Mangta517/flight/flight_remote_hal/MDK-ARM/air_schematic_page1.png

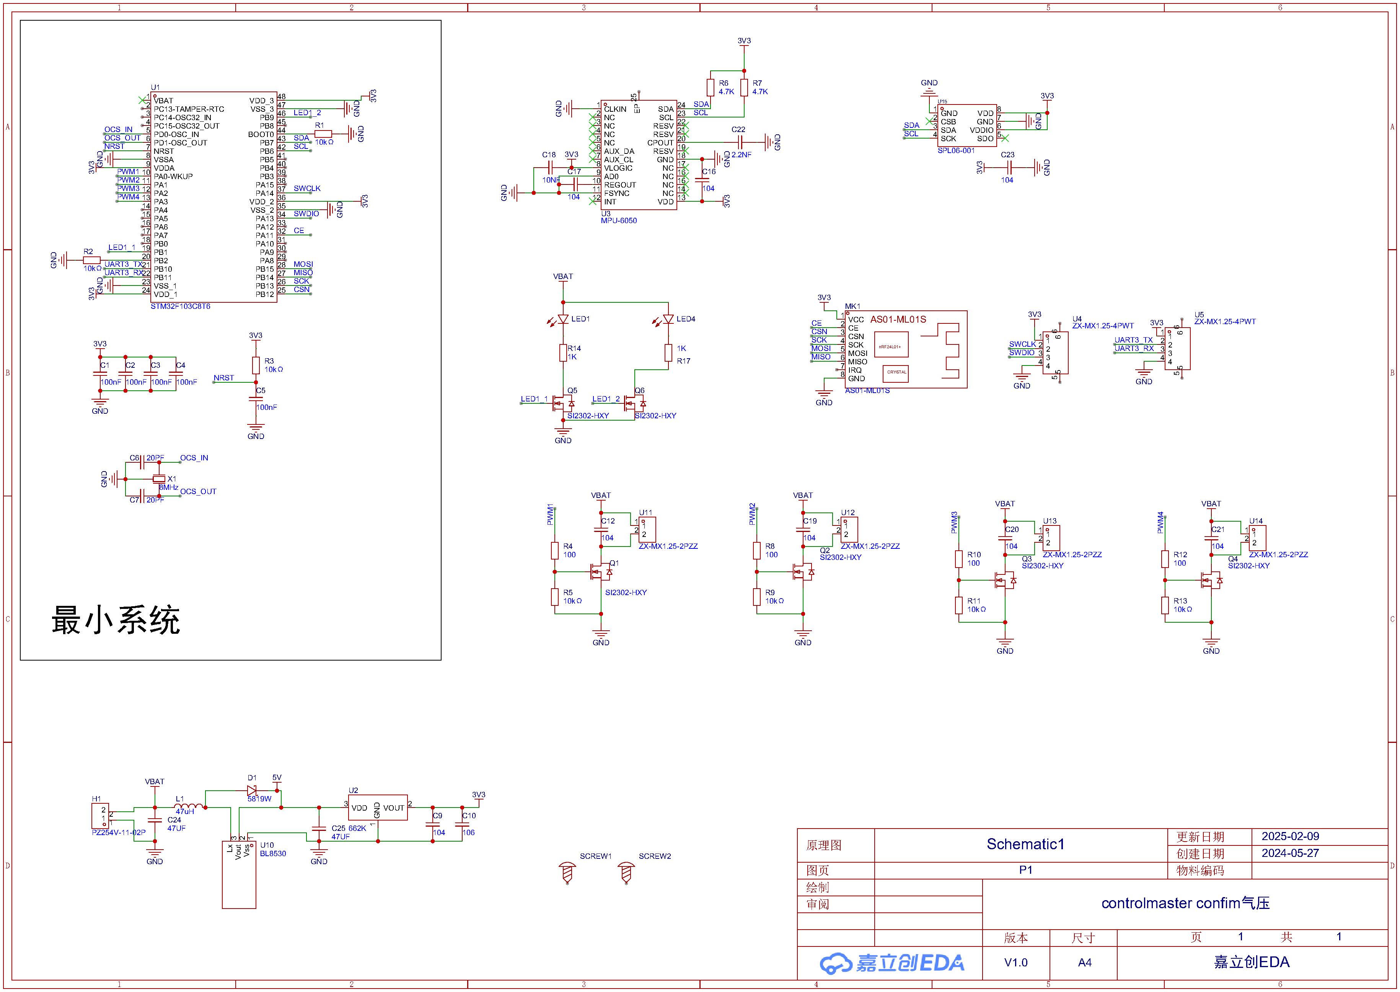
flight_remote_hal/MDK-ARM/air_schematic_page1.png
