Mangta517/flight/flight_remote_hal/MDK-ARM/air_schematic.pdf

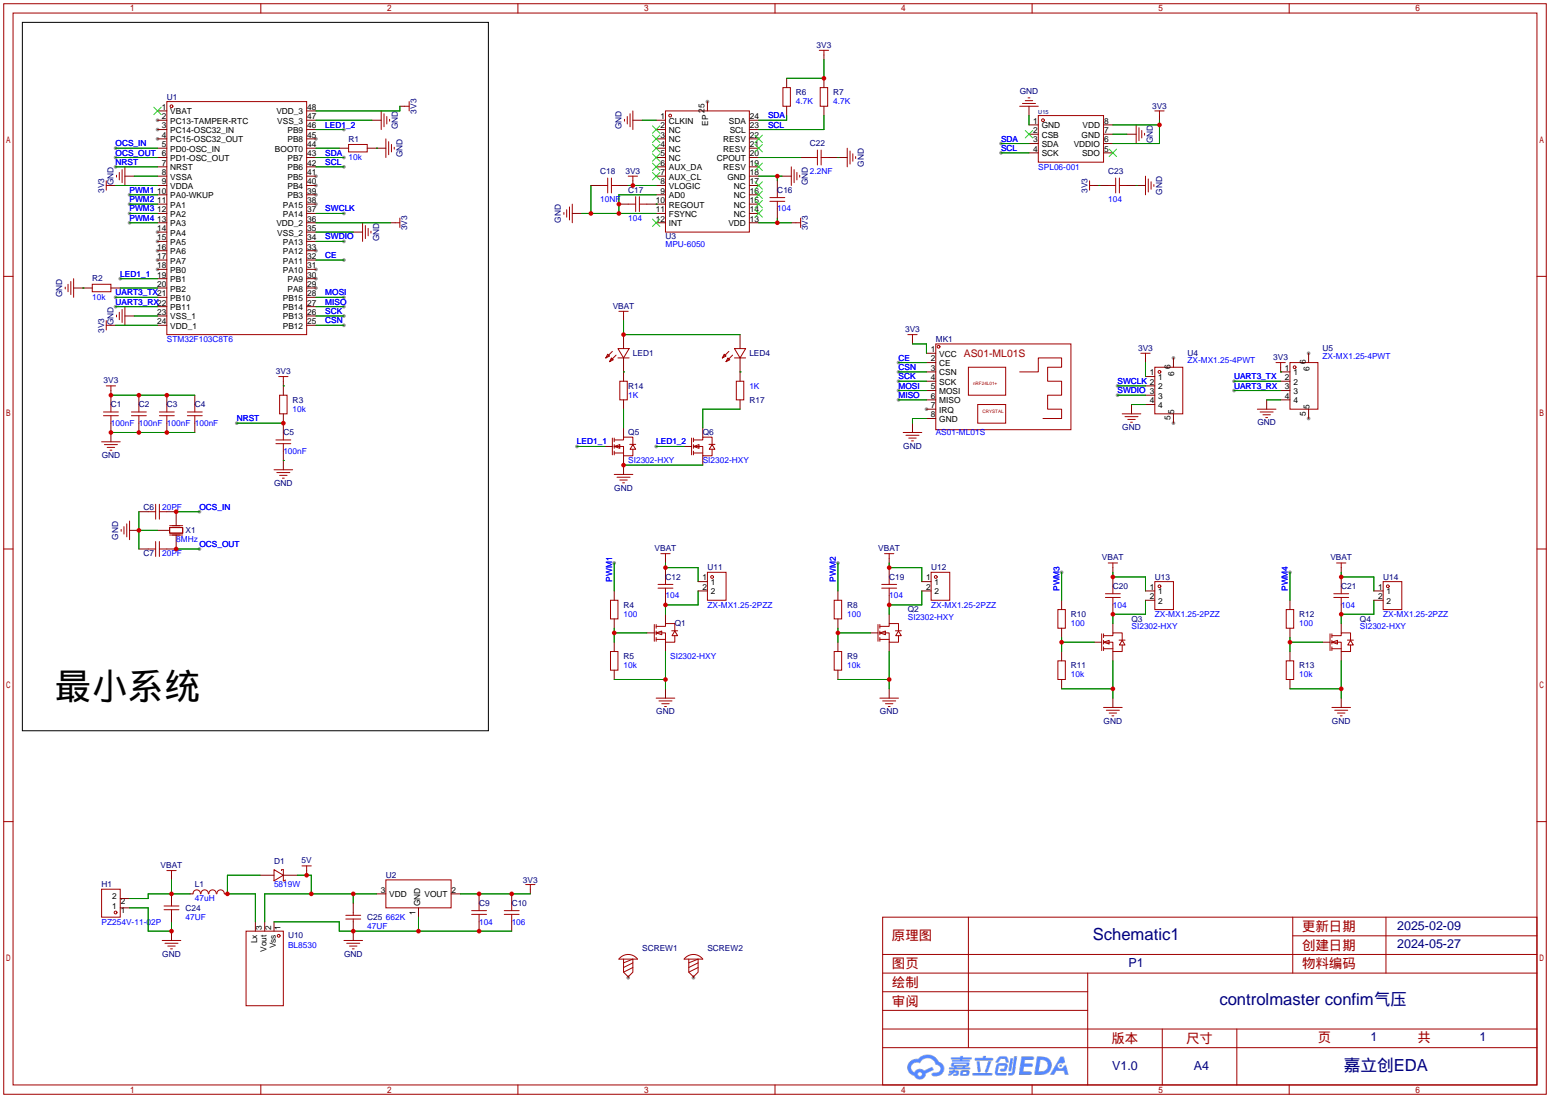
[picture p2: page 1]
