Mangta517/flight/flight_hal/Core/Src/main.c

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
/* Includes ------------------------------------------------------------------*/
#include "main.h"
#include "i2c.h"
#include "spi.h"
#include "tim.h"
#include "usart.h"
#include "gpio.h"

/* USER CODE BEGIN Includes */
#include "common_debug.h"
#include "application_freertos_task.h"
#include "nRF24L01P.h"
#include "spl006.h"
/* USER CODE END Includes */


void SystemClock_Config(void);
/**
  * @brief  The application entry point.
  * @retval int
  */
int main(void)
{

  /* MCU Configuration--------------------------------------------------------*/

  /* Reset of all peripherals, Initializes the Flash interface and the Systick. */
  HAL_Init();

  /* Configure the system clock */
  SystemClock_Config();

  /* Initialize all configured peripherals */
  MX_GPIO_Init();
  MX_USART3_UART_Init();
  MX_TIM2_Init();
  MX_SPI2_Init();
  MX_I2C1_Init();
  /* USER CODE BEGIN 2 */
//HAL_UART_Transmit(&huart3, (uint8_t *)"Hello World\r\n", 13, 1000);
//使用c语言的printf
debug_printf("Hello World\r\n");
Int_nRF24L01P_Init();
spl_Init();
application_freertos_start();


//启动FREERTOS,然后续的任务切换到FREERTOS的任务中去执行

vTaskStartScheduler();
  /* USER CODE END 2 */

  /* Infinite loop */
  /* USER CODE BEGIN WHILE */
  while (1)
  {
    /* USER CODE END WHILE */

    /* USER CODE BEGIN 3 */
  }
  /* USER CODE END 3 */
}

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
