Mangta517/flight/flight_remote_hal/Core/Inc/main.h

#define KEY_UP_Pin GPIO_PIN_14
#define KEY_UP_GPIO_Port GPIOC
#define KEY_DOWN_Pin GPIO_PIN_15
#define KEY_DOWN_GPIO_Port GPIOC
#define KEY_LEFT_Pin GPIO_PIN_6
#define KEY_LEFT_GPIO_Port GPIOA
#define KEY_RIGHT_Pin GPIO_PIN_7
#define KEY_RIGHT_GPIO_Port GPIOA
#define KEY_RIGHT_TOP_Pin GPIO_PIN_11
#define KEY_RIGHT_TOP_GPIO_Port GPIOB
#define SPI_NSS_Pin GPIO_PIN_12
#define SPI_NSS_GPIO_Port GPIOB
#define SPI_EN_Pin GPIO_PIN_11
#define SPI_EN_GPIO_Port GPIOA
#define BUZZ_Pin GPIO_PIN_12
#define BUZZ_GPIO_Port GPIOA
#define KEY_LEFT_TOP_Pin GPIO_PIN_15
#define KEY_LEFT_TOP_GPIO_Port GPIOA
