Mangta517/flight/flight_remote_hal/MDK-ARM/interface/oledfont.h

#ifndef __OLEDFONT_H
#define __OLEDFONT_H

extern const unsigned char oled_asc2_1206[95][12];
extern const unsigned char oled_asc2_1608[95][16];
extern const unsigned char oled_CH_1616[][12];
extern const unsigned char oled_CH15[][12];

#endif
