Mangta517/flight/(commit log)

2026-08-25 feat: 合并飞控与遥控端为一个组合仓库
    结构:
    - flight_hal/ 飞控端(STM32F103 姿态/定高/电机控制)
    - flight_remote_hal/ 遥控端(摇杆/按键/SPI通信)
    - README.md 项目说明 + 调参问题与调试记录
    - .gitignore 统一忽略 Keil 构建产物与机器配置
    背景: 原 flight_hal 与 flight_remote_hal 为两个分离仓库, 现整合为单仓库统一管理。
    包含: PID/配平角/电机补偿/死区/偏航修正/零漂抑制 等调参记录与实验过程。
2026-09-02 feat: 同步飞控与遥控端最新改动到组合仓库
    - flight_hal: 重构位置式PID(D项低通滤波/积分按dt归一), IMU动态dt, PID参数整定, 配平角调整, nRF24初始化超时, MAX_RETRY_COUNT 8
    - flight_remote_hal: 互斥锁替代关中断保障摇杆/显示/发送任务并发安全, 校准锁内提交, nRF24初始化超时
